becooper222/j-box/pi/jbox/config.py

"""Load and validate config.yaml."""
from __future__ import annotations

import sys
from dataclasses import dataclass, field
from datetime import date
from pathlib import Path

import yaml


@dataclass
class Occasion:
    month: int
    day: int
    label: str

    def matches(self, d: date) -> bool:
        return d.month == self.month and d.day == self.day


@dataclass
class Config:
    base_url: str
    device_token: str
    poll_seconds: int = 60
    width: int = 800
    height: int = 480
    fullscreen: bool = True
    driver: str = "kmsdrm"  # "fb" writes straight to /dev/fb0
    blank_hdmi: bool = False  # cutting HDMI strands this panel blank
    touch_swap_xy: bool = False
    touch_invert_x: bool = False
    touch_invert_y: bool = False
    rotate: int = 90  # applied when the panel's native mode is portrait
    typewriter_delay: float = 0.045
    font: str = "fonts/Caveat-Variable.ttf"
    greeting_seconds: float = 2.0
    scroll_speed: float = 16.0  # pixels per second for long notes
    led_pin: int = 12
    reed_pin: int = 26
    button_pin: int = 16
    button_hold_time: float = 0.8
    lid_closed_when_circuit_closed: bool = True
    always_open: bool = False  # dev: behave as if the lid is always open
    anniversary: date | None = None
    occasions: list[Occasion] = field(default_factory=list)

    def days_together(self, today: date) -> int | None:
        if not self.anniversary:
            return None
        return (today - self.anniversary).days + 1

    def occasion_today(self, today: date) -> Occasion | None:
        for occ in self.occasions:
            if occ.matches(today):
                return occ
        return None


def load(path: str | Path) -> Config:
    path = Path(path)
    if not path.exists():
        sys.exit(f"Config not found: {path}\nCopy config.example.yaml to config.yaml and edit it.")

    raw = yaml.safe_load(path.read_text()) or {}
    api = raw.get("api", {})
    disp = raw.get("display", {})
    gpio = raw.get("gpio", {})
    dates = raw.get("dates", {}) or {}
    dev = raw.get("dev", {}) or {}

    base_url = str(api.get("base_url", "")).rstrip("/")
    token = str(api.get("device_token", ""))
    if not base_url or token in ("", "CHANGE-ME"):
        sys.exit("config.yaml: api.base_url and api.device_token must be set.")

    anniversary = None
    if dates.get("anniversary"):
        anniversary = date.fromisoformat(str(dates["anniversary"]))

    occasions = []
    for item in dates.get("occasions") or []:
        month, day = (int(x) for x in str(item["date"]).split("-"))
        occasions.append(Occasion(month=month, day=day, label=str(item["label"])))

    return Config(
        base_url=base_url,
        device_token=token,
        poll_seconds=int(api.get("poll_seconds", 60)),
        width=int(disp.get("width", 800)),
        height=int(disp.get("height", 480)),
        fullscreen=bool(disp.get("fullscreen", True)),
        driver=str(disp.get("driver", "kmsdrm")),
        blank_hdmi=bool(disp.get("blank_hdmi", False)),
        always_open=bool(dev.get("always_open", False)),
        touch_swap_xy=bool(disp.get("touch_swap_xy", False)),
        touch_invert_x=bool(disp.get("touch_invert_x", False)),
        touch_invert_y=bool(disp.get("touch_invert_y", False)),
        rotate=int(disp.get("rotate", 90)),
        typewriter_delay=float(disp.get("typewriter_delay", 0.045)),
        font=str(disp.get("font", "fonts/Caveat-Variable.ttf")),
        greeting_seconds=float(disp.get("greeting_seconds", 2.0)),
        scroll_speed=float(disp.get("scroll_speed", 16.0)),
        led_pin=int(gpio.get("led_pin", 12)),
        reed_pin=int(gpio.get("reed_pin", 26)),
        button_pin=int(gpio.get("button_pin", 16)),
        button_hold_time=float(gpio.get("button_hold_time", 0.8)),
        lid_closed_when_circuit_closed=bool(gpio.get("lid_closed_when_circuit_closed", True)),
        anniversary=anniversary,
        occasions=occasions,
    )
