becooper222/j-box/(commit log)

2026-08-27 J-Box: Pi app, 3D case, wiring and setup docs
    Claude-Session: https://claude.ai/code/session_01CAneUPiqKZpevy7E26Nds9
    [boot-config-append.txt, jbox_case.scad]
2026-08-27 Fix Lite-OS GL deps, portrait panel rotation, touch mapping
    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
    [app.py, config.py]
2026-08-28 Stop cutting HDMI at idle; add dev always-open mode
    Blanking via display_power left this panel backlit-but-blank with no
    reliable resync. Idle now just renders black, and startup forces the
    signal back on to recover a stranded panel.
    dev.always_open keeps the box awake and auto-reveals arriving notes
    while no reed switch is wired.
    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
2026-08-28 Use panel's native 480x800 mode; rotate landscape UI onto it
    Forcing an 800x480 mode made the panel duplicate every frame with a
    diagonal seam - visible even in the Linux console, so not a drawing bug.
    Dropping the hdmi_cvt override and letting EDID pick 480x800 gives a
    clean scanout; FbDisplay now rotates the 800x480 canvas onto the
    portrait panel and maps touches back through the same transform.
    Also drops the frame rate to 8fps when nothing is animating.
    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
    [app.py, config.example.yaml, fbdisplay.py]
2026-08-28 Move LED/reed off the LCD's pins; document GPIO needs for touch
    The panel drives GPIO18 as backlight PWM and covers physical pins 1-26,
    so the LED moves to GPIO12 and the reed to GPIO26 (pins 32/37).
    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
2026-08-28 Replace touchscreen input with a single physical button
    This panel's XPT2046 needs the GPIO header, which we are not using, so
    touch never had an electrical path. One momentary button now carries the
    whole interaction: tap sends the heart, hold walks back through the
    archive one note at a time (a list needs a pointer; a button does not).
    SIGUSR1/SIGUSR2 fake a tap/hold so the flow is testable before the
    button is soldered.
    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
    [app.py, config.example.yaml, config.py, hardware.py]
2026-08-28 Update README and case for the heart button
    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
    [jbox_case.scad]
2026-09-03 Handwritten UI: greeting, scrolling notes, favorites archive
    The reveal now opens with a time-aware greeting (or the occasion banner)
    held for a beat before the note types out in Caveat, a handwriting face
    bundled under OFL. Notes too tall for the panel drift upward after a
    pause to read the top.
    Hearting is quiet - the outline fills, sent appears briefly, and the
    LED gives two warm beats. Holding the button now browses only the notes
    she has hearted rather than everything.
    When several notes are unread the oldest shows first and the button
    steps through the rest; the on-screen hint says which the button means.
    Claude-Session: https: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
    [app.py, config.example.yaml, config.py, hardware.py]
2026-09-03 Center notes on screen; kill the console cursor
    The blinking bar in the corner was the kernel console cursor on the same
    framebuffer we draw to - disabled at runtime and via cmdline so it stays
    gone across reboots.
    Notes are now centered both ways by one shared helper used by the
    reveal, reading and archive views. Lines center on their full width even
    mid-typewriter, so the text does not shuffle sideways as it lands.
    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
    [app.py]
2026-09-03 Minimal button labels; lay the footer out from the bottom edge
    The heart now carries its own "press" label, so the only separate hint
    left is the one thing she cannot infer - that a hold opens favorites -
    and it retires after a few seconds. Notes queued behind this one still
    say so, since that changes what the button does.
    Footer positions derive from the panel's bottom edge rather than fixed
    offsets, which is what pushed the label off-screen, and it reserves
    enough height that a scrolling note cannot run underneath it.
    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
    [app.py]
